jdillenburg/TreeLedController/schematics.png

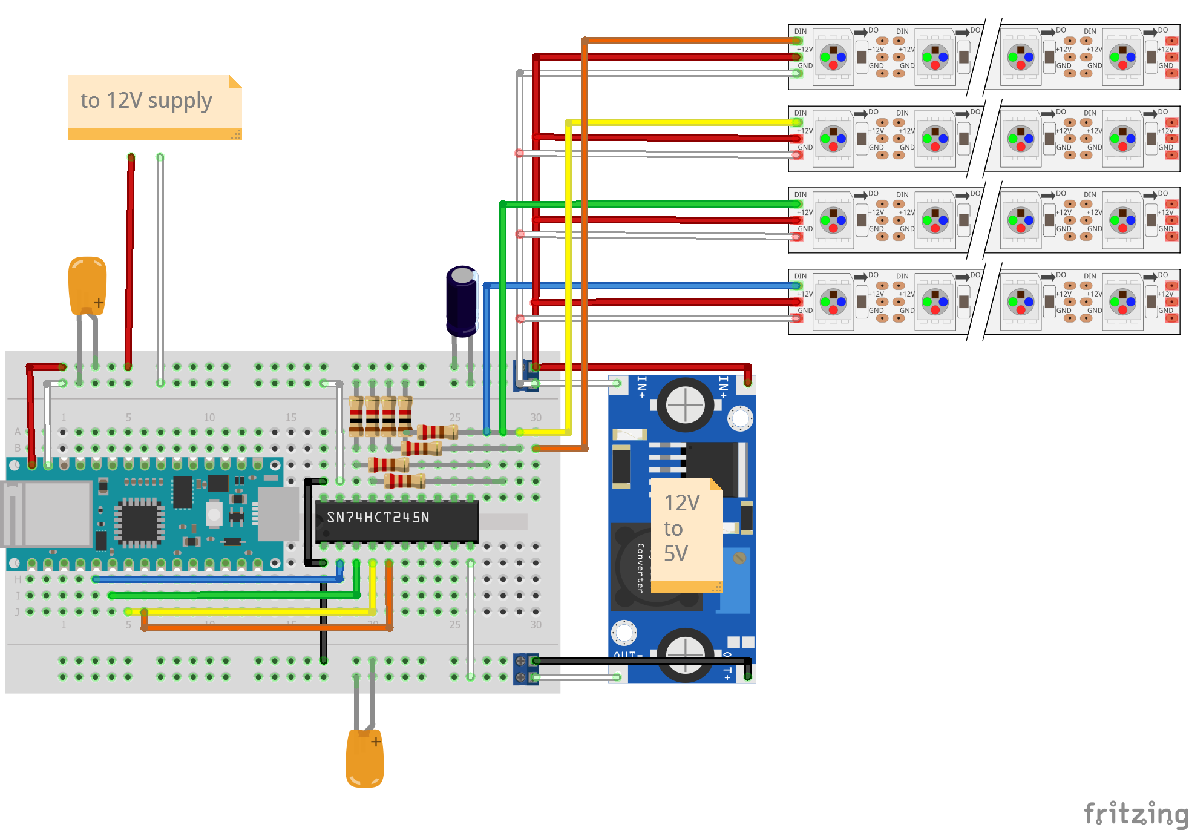
schematics.png
